behollan/SwarmBot/images/Charuco.jpg

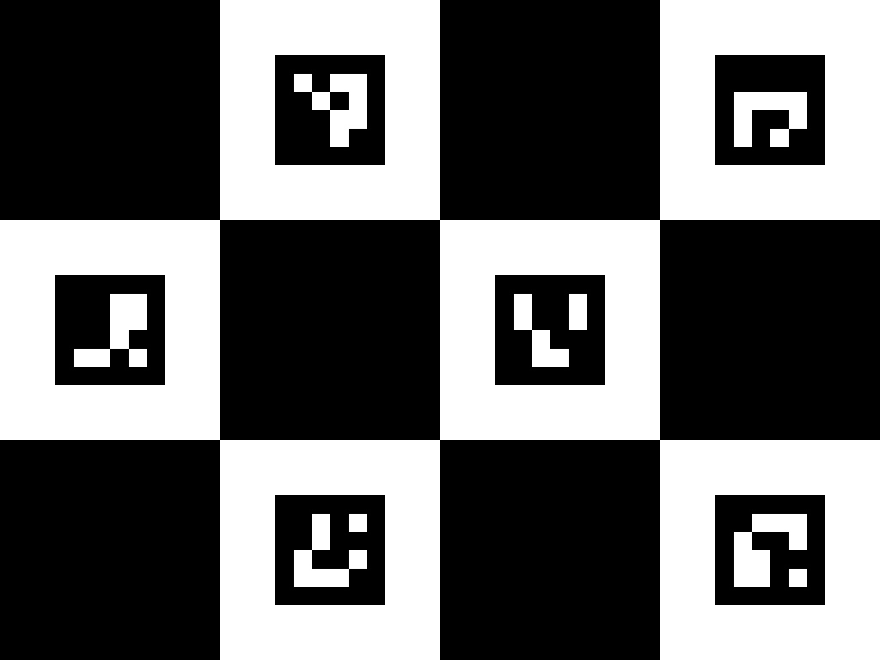
images/Charuco.jpg
