behollan/SwarmBot/images/Charuco_d0_h5_w7.jpg

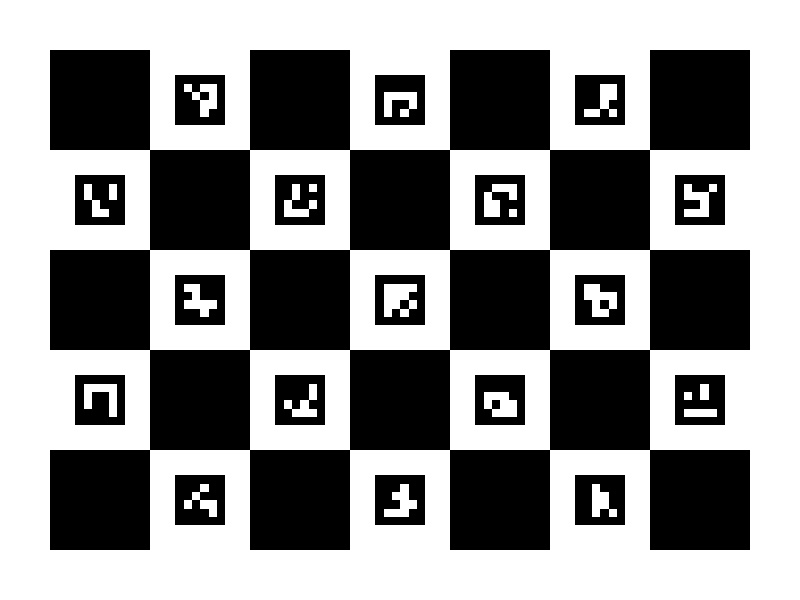
images/Charuco_d0_h5_w7.jpg
