behollan/SwarmBot/images/DetectedCorners.jpg

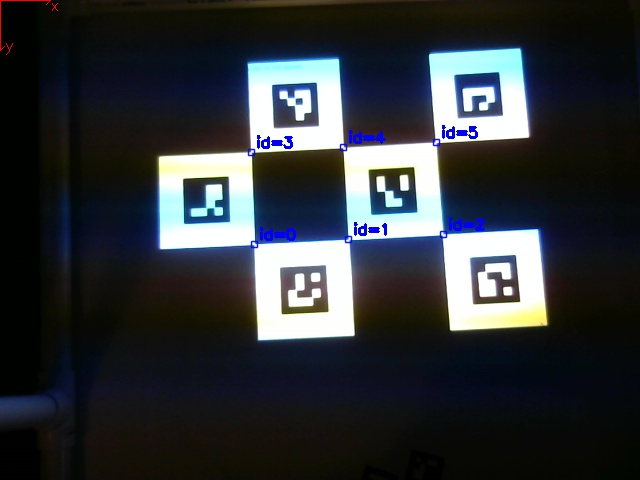
images/DetectedCorners.jpg
