behollan/SwarmBot/images/detectedImg.jpg

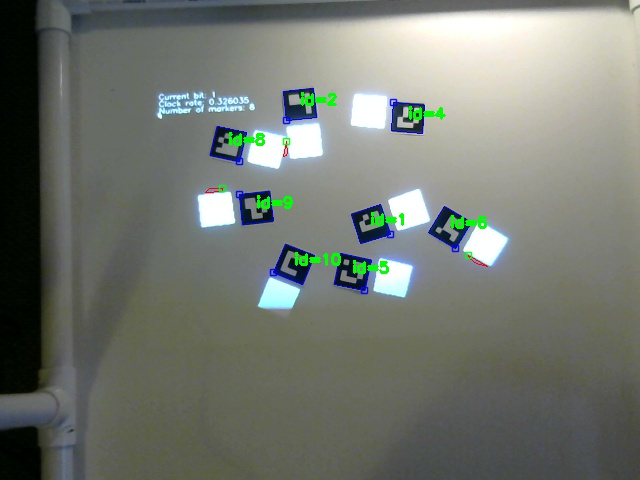
images/detectedImg.jpg
