behollan/SwarmBot/images/outImg.jpg

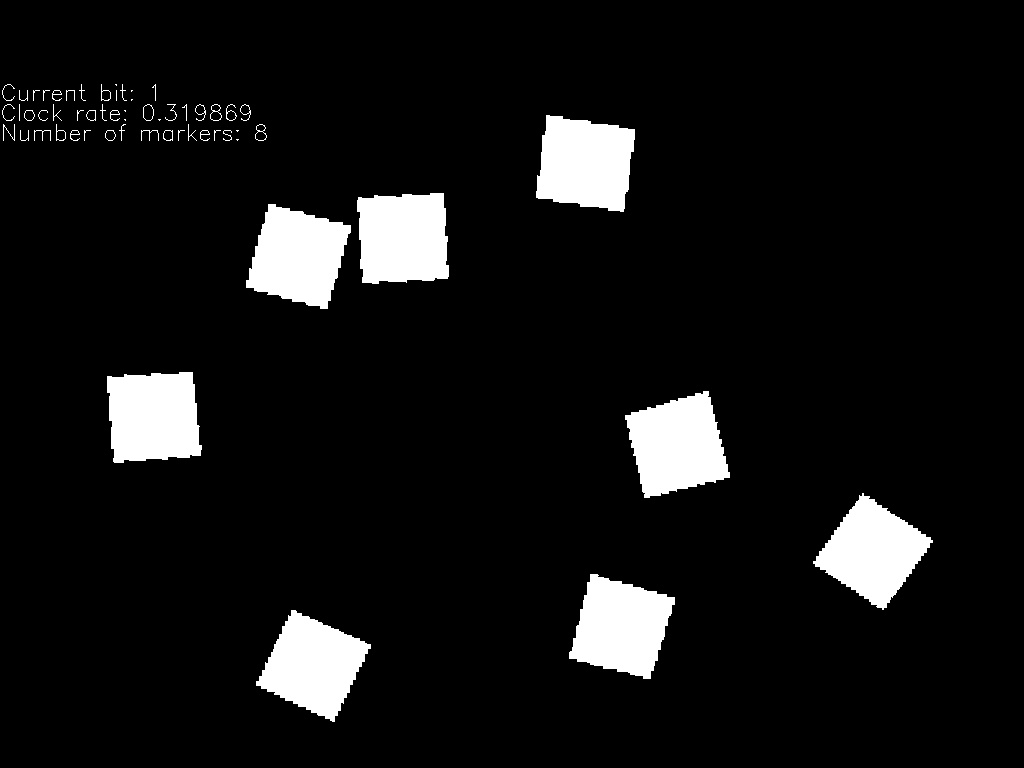
images/outImg.jpg
