behollan/SwarmBot/(threads)

Thread 1 (2017-08-31):

Homography Transform

behollan, 2017-08-31:
Add homography transform between camera frame and projector frame. Goal is to take a coordinate in the camera's frame and transform it to a coordinate in the projector's frame.

- Given xyz for the projector, get xyz for the projector

[OpenCv Homography Documentation](http://docs.opencv.org/2.4/modules/calib3d/doc/camera_calibration_and_3d_reconstruction.html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)

[Homo.pdf](https://github.com/behollan/SwarmBot/files/1265628/lecture16.pdf)

behollan, 2017-11-30:
Merged in #6

Closed 2017-11-30.
