behollan/SwarmBot/src/arucoTest.cpp

/*
By downloading, copying, installing or using the software you agree to this
license. If you do not agree to this license, do not download, install,
copy or use the software.

                          License Agreement
               For Open Source Computer Vision Library
                       (3-clause BSD License)

Copyright (C) 2013, OpenCV Foundation, all rights reserved.
Third party copyrights are property of their respective owners.

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
  * Neither the names of the copyright holders nor the names of the contributors
    may be used to endorse or promote products derived from this software
    without specific prior written permission.

This software is provided by the copyright holders and contributors "as is" and
any express or implied warranties, including, but not limited to, the implied
warranties of merchantability and fitness for a particular purpose are
disclaimed. In no event shall copyright holders or contributors be liable for
any direct, indirect, incidental, special, exemplary, or consequential damages
(including, but not limited to, procurement of substitute goods or services;
loss of use, data, or profits; or business interruption) however caused
and on any theory of liability, whether in contract, strict liability,
or tort (including negligence or otherwise) arising in any way out of
the use of this software, even if advised of the possibility of such damage.
*/


#include <opencv2/highgui.hpp>
#include <opencv2/aruco.hpp>
#include <iostream>
#include "../include/arucoTest.h"

using namespace std;
using namespace cv;

bool arucoDetect(int d) {

    int dictionaryId = d;
    bool showRejected = false;
    bool estimatePose = false;
    float markerLength = 1;

    int camId = 0;

    Ptr<aruco::Dictionary> dictionary =
        aruco::getPredefinedDictionary(aruco::PREDEFINED_DICTIONARY_NAME(dictionaryId));

    Mat camMatrix, distCoeffs;

    VideoCapture inputVideo;
    int waitTime;
    inputVideo.open(camId);
    waitTime = 10;
    
    double totalTime = 0;
    int totalIterations = 0;

    while(inputVideo.grab()) {
        Mat image, imageCopy;
        inputVideo.retrieve(image);

        double tick = (double)getTickCount();

        vector< int > ids;
        vector< vector< Point2f > > corners, rejected;
        vector< Vec3d > rvecs, tvecs;

        // detect markers and estimate pose
        aruco::detectMarkers(image, dictionary, corners, ids);
        double currentTime = ((double)getTickCount() - tick) / getTickFrequency();
        totalTime += currentTime;
        totalIterations++;
        if(totalIterations % 30 == 0) {
            cout << "Detection Time = " << currentTime * 1000 << " ms "
                 << "(Mean = " << 1000 * totalTime / double(totalIterations) << " ms)" << endl;
        }

        // draw results
        image.copyTo(imageCopy);
        if(ids.size() > 0) {
            aruco::drawDetectedMarkers(imageCopy, corners, ids);
        }

        imshow("out", imageCopy);
        char key = (char)waitKey(waitTime);
        if(key == 27) break;
    }
    return 0;
}
