behollan/SwarmBot/(commit log)

2017-09-16 Added CMake Files Added Camera Functionality for Logitech C270 webcam
2017-10-23 Added information from spring 2017 paper
2017-10-23 Adding Spring 2017 Paper
2017-10-27 Broke apart into command line application Reworked file structure Reworked CMakeLists to be more portable
    [Console.cpp, arucoTest.cpp, main.cpp]
2017-11-27 Added cmake files for Raspberry Pi
2017-11-28 Added new pythonic host controller. Added calibration files.
2017-12-13 Added sample images
